tmcit-ararobo-2026a/bridge-writer/README.md

# <bridge-writer>

<!-- 一行でプロジェクトを説明する -->
<can経由で他基板へと書き込める通信基板と基板のコード>

## 目次

1. [概要](#1-概要)
2. [ドキュメント](#2-ドキュメント)
3. [コントリビューション](#3-コントリビューション)
4. [ビルド・使い方](#4-ビルド使い方)
5. [システム構成](#5-システム構成)
6. [ライセンス](#6-ライセンス)

## 1. 概要

<!-- プロジェクトの目的・背景・解決する課題を記述 -->

## 2. ドキュメント

| ドキュメント | 説明 |
| :-: | :-: |
| [CONTRIBUTING.md](./CONTRIBUTING.md) | 開発フロー・コミット規約・コーディング規約 |
| [docs/coding-rules.md](./docs/coding-rules.md) | コーディング規約の詳細 |
| [docs/uml/](./docs/uml/) | UML図 |

## 3. コントリビューション

[CONTRIBUTING.md](./CONTRIBUTING.md) を参照してください。

## 4. ビルド・使い方

<!-- ビルドのやり方 -->
<!-- 使い方 -->

## 5. システム構成

<!-- ROS2ノード構成・STM32との通信方式・ハードウェア構成 等 -->
<!-- 依存クラスが3つ以上ある場合は docs/uml/ にUML図を作成し、ここにリンクする -->

## 6. ライセンス

本リポジトリは [MITライセンス](./LICENSE) のもとで公開されています。
