tmcit-ararobo-2026a/bridge-writer/PCB/BridgeWriter_v1/BridgeWriter_v1.kicad_pcb

## KiCad design PCB/BridgeWriter_v1/BridgeWriter_v1.kicad_pcb (continued)

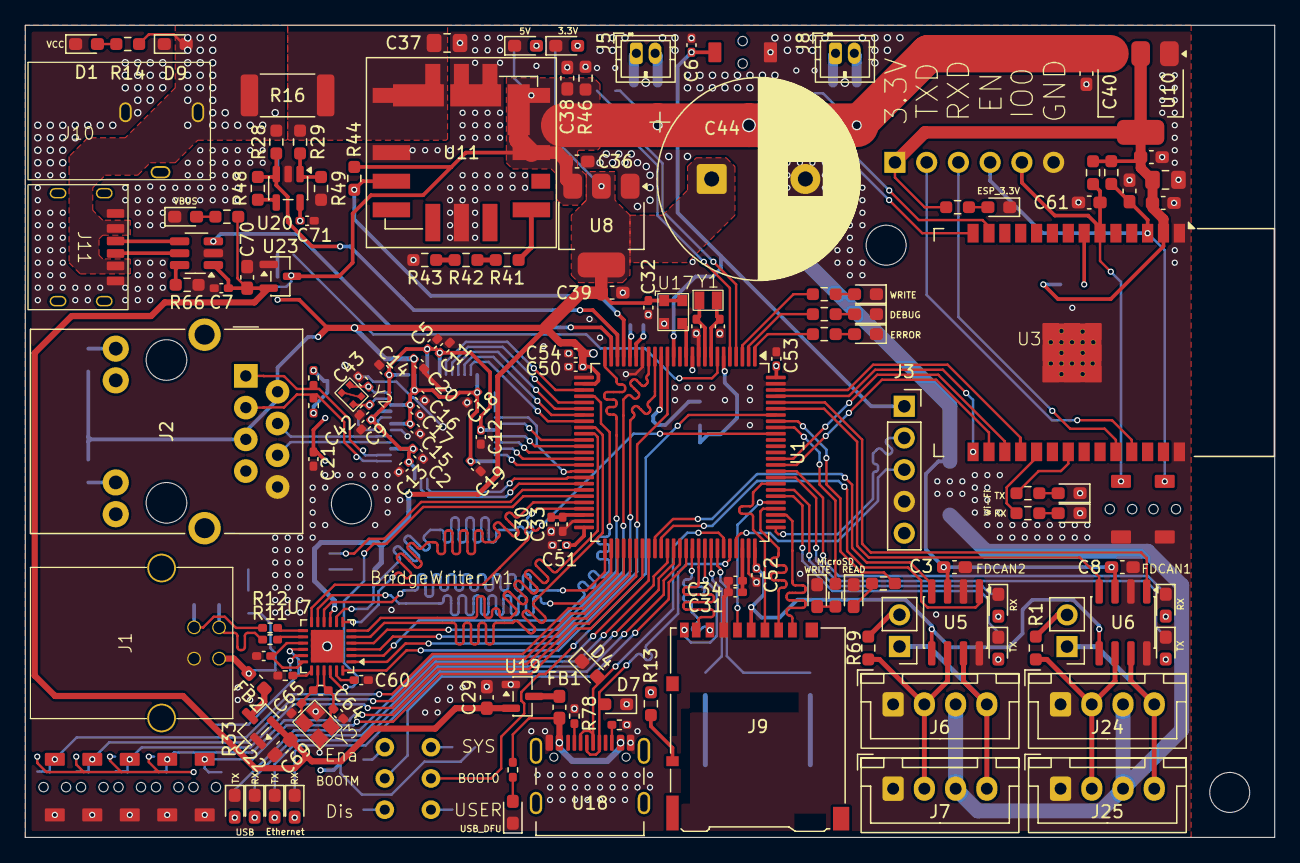
[picture p7: board BridgeWriter_v1.kicad_pcb from above]

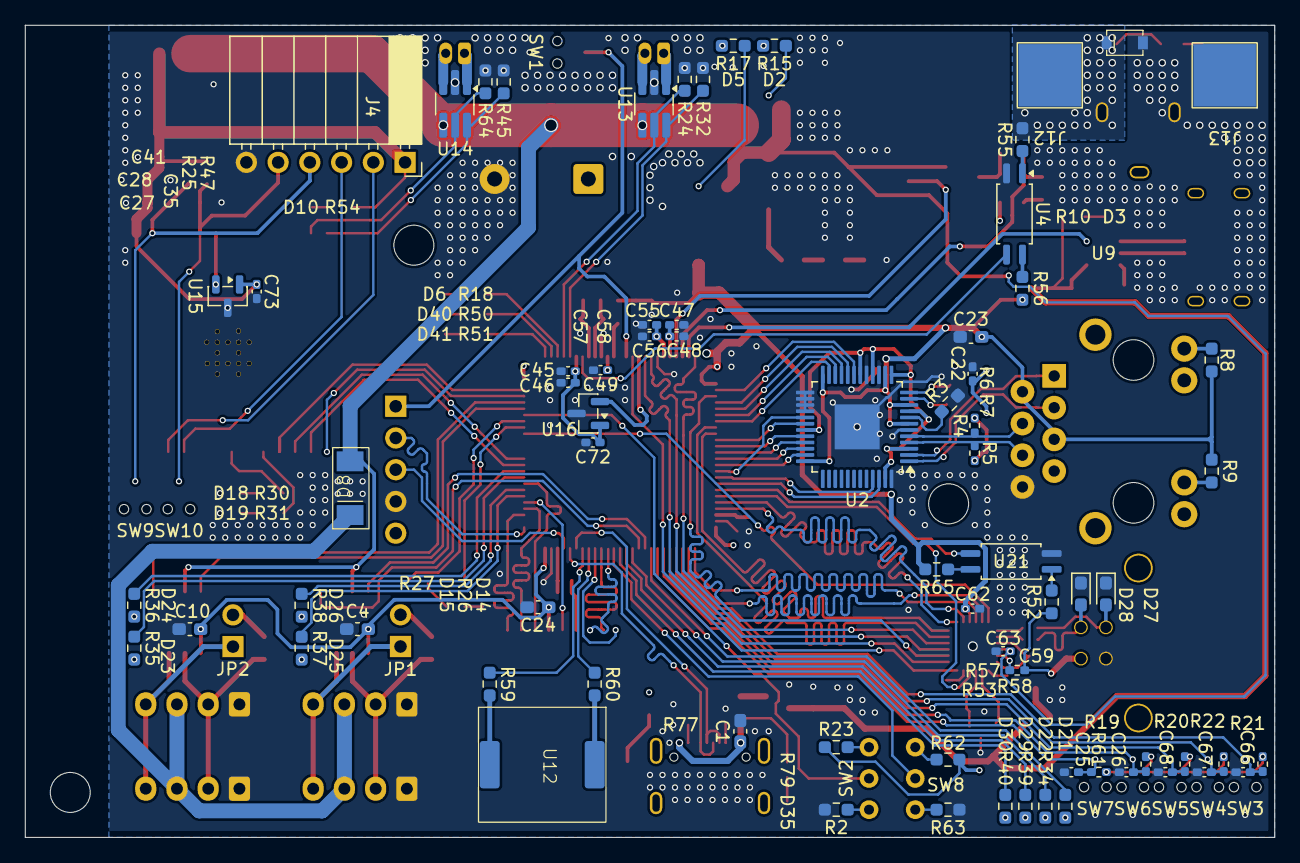
[picture p8: board BridgeWriter_v1.kicad_pcb from below]

Board: 4 copper layers, 100.0 x 65.0 mm, 229 parts (72 on the bottom side), 176 nets.

Other parts of the board:
H2, H2#2, H2#3: MountingHole; MountingHole_3.2mm_M3
