tmcit-ararobo-2026a/bridge-writer/Code/BridgeWriter_v1.ioc

Mcu.UserName=STM32H723VGTx
PA0.GPIO_Label=PGOOD
PA0.Signal=GPIO_Input
PA1.GPIO_Label=POWER_MONITOR
PA1.Signal=ADC1_INP17
PA10.GPIO_Label=Speaker_IN2
PA10.Signal=S_TIM1_CH3
PA13(JTMS/SWDIO).Signal=DEBUG_JTMS-SWDIO
PA14(JTCK/SWCLK).Signal=DEBUG_JTCK-SWCLK
PA2.GPIO_Label=USB_PD_GOOD
PA2.Signal=GPIO_Input
PA3.Signal=USB_OTG_HS_ULPI_D0
PA4.GPIO_Label=W6300_LNK
PA4.Signal=GPIO_Input
PA5.Signal=USB_OTG_HS_ULPI_CK
PA6.GPIO_Label=W6300_SPD
PA6.Signal=GPIO_Input
PA7.GPIO_Label=W6300_DPXn
PA7.Signal=GPIO_Input
PA8.GPIO_Label=SDMMC_CHECK
PA8.Signal=GPIO_Input
PA9.GPIO_Label=Speaker_IN1
PA9.Signal=S_TIM1_CH2
PB0.Signal=USB_OTG_HS_ULPI_D1
PB1.Signal=USB_OTG_HS_ULPI_D2
PB10.Signal=USB_OTG_HS_ULPI_D3
PB11.Signal=USB_OTG_HS_ULPI_D4
PB12.Signal=USB_OTG_HS_ULPI_D5
PB13.Signal=USB_OTG_HS_ULPI_D6
PB14.GPIO_Label=FDCAN1_RESET
PB14.Signal=GPIO_Input
PB15.GPIO_Label=FDCAN2_RESET
PB15.Signal=GPIO_Input
PB2.Signal=OCTOSPIM_P1_CLK
PB5.Signal=USB_OTG_HS_ULPI_D7
PB6.GPIO_Label=SDMMC_WRITE_LED
PB6.Signal=GPIO_Output
PB7.GPIO_Label=SDMMC_READ_LED
PB7.Signal=GPIO_Output
PB8.Signal=FDCAN1_RX
PB9.Signal=FDCAN1_TX
PC0.Signal=USB_OTG_HS_ULPI_STP
PC1.Signal=ADCx_INP11
PC10.Signal=SDMMC1_D2
PC11.Signal=SDMMC1_D3
PC12.Signal=SDMMC1_CK
PC13.GPIO_Label=POWER_MONITOR
PC13.Signal=GPIO_Input
PC14-OSC32_IN.Signal=RCC_OSC32_IN
PC15-OSC32_OUT.Signal=RCC_OSC32_OUT
PC2_C.Signal=USB_OTG_HS_ULPI_DIR
PC3_C.Signal=USB_OTG_HS_ULPI_NXT
PC4.GPIO_Label=W6300_ACT
PC4.Signal=GPXTI4
PC5.GPIO_Label=W6300_COL
PC5.Signal=GPXTI5
PC6.GPIO_Label=Ethernet_RX_LED
PC6.Signal=GPIO_Output
PC7.GPIO_Label=BOOTMODE
PC7.Signal=GPIO_Input
PC8.Signal=SDMMC1_D0
PC9.Signal=SDMMC1_D1
PD0.GPIO_Label=FDCAN2_TX_LED
PD0.Signal=GPIO_Output
PD1.GPIO_Label=FDCAN2_RX_LED
PD1.Signal=GPIO_Output
PD10.GPIO_Label=Wi-Fi_RESET
PD10.Signal=GPIO_Input
PD11.GPIO_Label=USB_TX_LED
PD11.Signal=GPIO_Output
PD12.Signal=FDCAN3_RX
PD13.Signal=FDCAN3_TX
PD14.GPIO_Label=USB_RX_LED
PD14.Signal=GPIO_Output
PD15.GPIO_Label=Ethernet_TX_LED
PD15.Signal=GPIO_Output
PD2.Signal=SDMMC1_CMD
PD3.GPIO_Label=FDCAN1_TX_LED
PD3.Signal=GPIO_Output
PD4.GPIO_Label=FDCAN1_RX_LED
PD4.Signal=GPIO_Output
PD5.Signal=USART2_TX
PD6.Signal=USART2_RX
PD8.GPIO_Label=Ethernet_RESET
PD8.Signal=GPIO_Input
PD9.GPIO_Label=USB_RESET
PD9.Signal=GPIO_Input
PE0.GPIO_Label=FW_UART_TXF
PE0.Signal=GPIO_Output
PE1.GPIO_Label=FW_UART_RXF
PE1.Signal=GPIO_Input
PE10.Signal=OCTOSPIM_P1_IO7
PE11.Signal=OCTOSPIM_P1_NCS
PE12.GPIO_Label=W6300_INT
PE12.Signal=GPXTI12
PE13.GPIO_Label=W6300_RST
PE13.Signal=GPIO_Output
PE14.GPIO_Label=USB_HS_CHECK
PE14.Signal=GPIO_Input
PE15.GPIO_Label=USB3343_RST
PE15.Signal=GPIO_Output
PE2.GPIO_Label=ERROR_LED
PE2.Signal=GPIO_Output
PE3.GPIO_Label=DEBUG_LED
PE3.Signal=GPIO_Output
PE4.GPIO_Label=WRITE_MODE_LED
PE4.Signal=GPIO_Output
PE5.GPIO_Label=FAN_INB
PE5.Signal=S_TIM15_CH1
PE6.GPIO_Label=FAN_INA
PE6.Signal=S_TIM15_CH2
PE7.Signal=OCTOSPIM_P1_IO4
PE8.Signal=OCTOSPIM_P1_IO5
PE9.Signal=OCTOSPIM_P1_IO6
PH0-OSC_IN.Signal=RCC_OSC_IN
