tmcit-ararobo-2026a/bridge-writer/(commit log)

2026-03-15 add ESP32_UART and creatting PCB
    [BridgeWriter_v0.kicad_pcb, BridgeWriter_v0.kicad_sch]
2026-03-17 All the wiring except the power is probably done.
    [BridgeWriter_v0.kicad_pcb, BridgeWriter_v0.kicad_sch]
2026-03-18 Completed PCB
    [BridgeWriter_v0.kicad_pcb, BridgeWriter_v0.kicad_sch, bom.csv, designators.csv, positions.csv]
2026-03-19 基盤でdfu機能使えるけど肝心のusbつけてなかった
    [BridgeWriter_v1.kicad_pcb, BridgeWriter_v1.kicad_sch, bom.csv, designators.csv, positions.csv]
2026-03-19 DFUのType-C追加 FDCANのピン間違い修正 電源供給はUSB PDにしようかなと
    [BridgeWriter_v1.kicad_pcb, BridgeWriter_v1.kicad_sch]
2026-03-21 基板にTVSダイオードと逆接保護追加 給電をUSB PD かDC ジャックにしようと思う サージ電圧保護とOCPとOVPを追加する予定
    [BridgeWriter_v1.kicad_pcb, BridgeWriter_v1.kicad_sch]
2026-03-22 USB PD追加
    [BridgeWriter_v1.kicad_pcb, BridgeWriter_v1.kicad_sch]
2026-03-22 フォルダの作成
    [BridgeWriter_v1.kicad_pcb, BridgeWriter_v1.kicad_sch]
2026-03-22 app/cmakelistsの追加
2026-03-22 docs : PCB作成途中 書き込み基板のPCBを一から作り直し
    [BridgeWriter_v1.kicad_pcb, BridgeWriter_v1.kicad_sch]
2026-03-23 PCB電源LED以外配線終わり やること LED追加と、シルクの被り解消
    [BridgeWriter_v1.kicad_pcb, BridgeWriter_v1.kicad_sch]
2026-03-24 ほぼ完成
    [BridgeWriter_v1.kicad_pcb, BridgeWriter_v1.kicad_sch, bom.csv, designators.csv, positions.csv]
2026-03-24 PCB一応完成
    [BridgeWriter_v1.kicad_pcb]
2026-03-25 feat : GENERATE CODE fdcanクラスの作成
    ブランチの追加たがまだわかっていないので次回からブランチを使います。
    [BridgeWriter_v1.kicad_sch]
2026-03-25 fix fdcan追加
2026-03-25 feat : timeoutと送信完了割り込みを追加
    ハードウェア側での受信タイムアウトの追加
    送信完了割り込みを追加
2026-03-25 fdcan内のSend追加
2026-03-26 新しいfdacnクラスの作成９割完成
2026-03-26 PCB 変更シルクを少しつけた
    [BridgeWriter_v1.kicad_pcb, bom.csv, designators.csv]
2026-03-27 classic can fdcanの選択はありにする
2026-03-28 勝手に改行擦れてしまうのを解除
